Cd1314520/ps5-robotic-arm/hardware/stl/01-base.stl

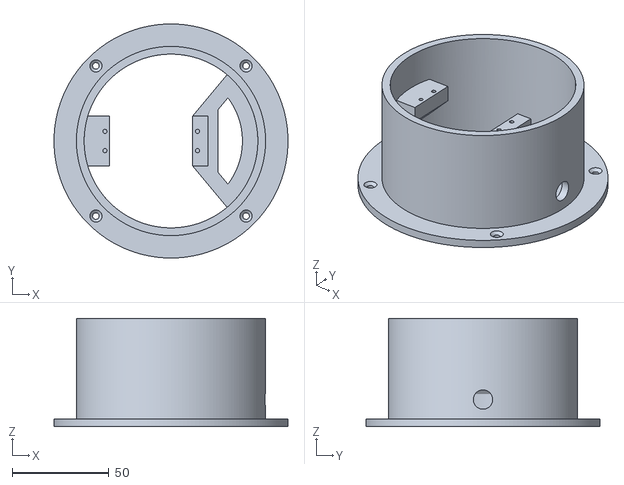
[picture p1: CAD file, 2026-10-28]
hardware/stl/01-base.stl
121.2 x 121.3 x 56.0
