Cd1314520/ps5-robotic-arm/hardware/stl/02-base-mount-mg996r.stl

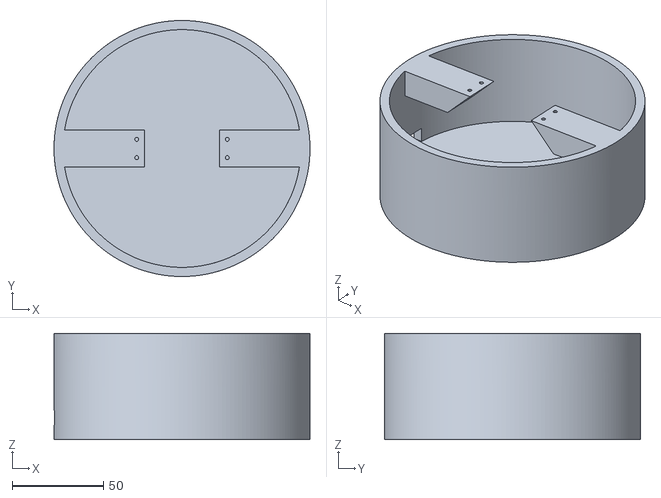
[picture p2: CAD file, 2026-10-28]
hardware/stl/02-base-mount-mg996r.stl
140.0 x 140.0 x 58.0
