Cd1314520/ps5-robotic-arm/hardware/stl/09-gripper-base.stl

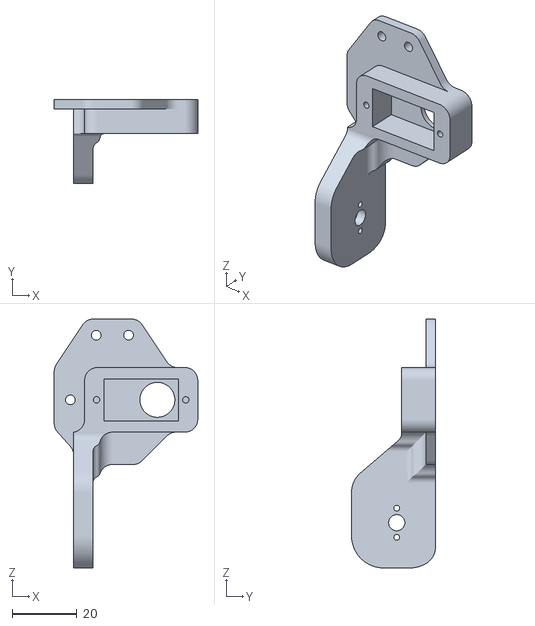
[picture p3: CAD file, 2026-10-28]
hardware/stl/09-gripper-base.stl
44.4 x 26.0 x 77.0
