Cd1314520/ps5-robotic-arm/hardware/stl/05-arm-01.stl

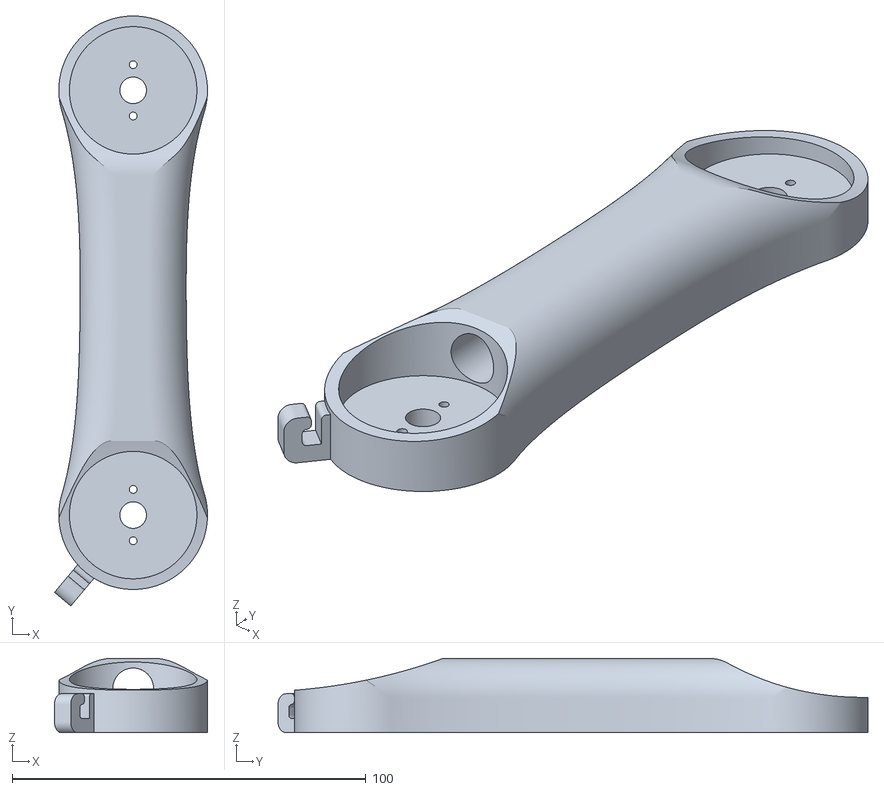
[picture p4: CAD file, 2026-10-28]
hardware/stl/05-arm-01.stl
43.2 x 166.7 x 21.0
