Cd1314520/ps5-robotic-arm/hardware/stl/07-arm-02.stl

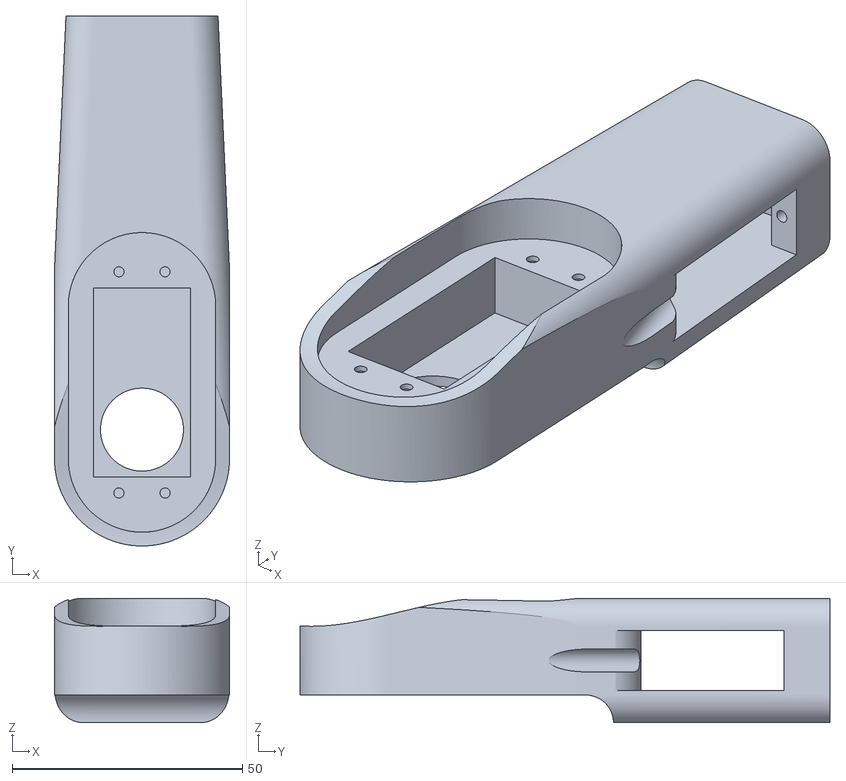
[picture p5: CAD file, 2026-10-28]
hardware/stl/07-arm-02.stl
38.0 x 115.0 x 27.0
