Cd1314520/ps5-robotic-arm/hardware/stl/03-waist.stl

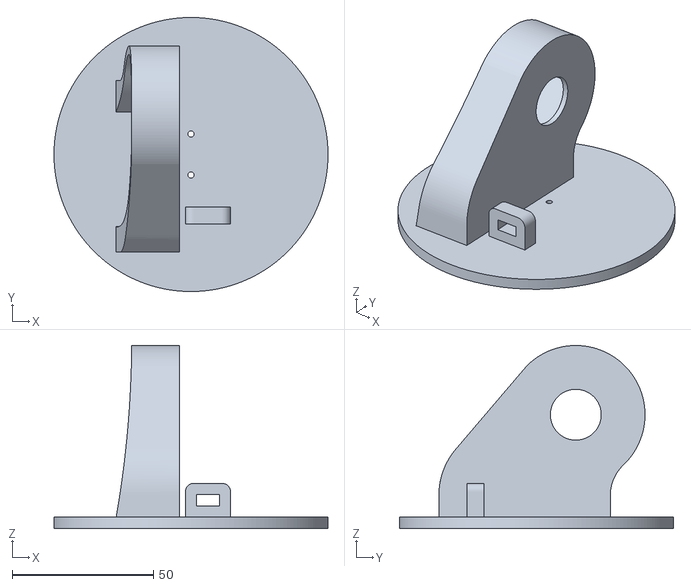
[picture p6: CAD file, 2026-10-28]
hardware/stl/03-waist.stl
97.0 x 97.0 x 64.8
