Cd1314520/ps5-robotic-arm/hardware/stl/08-arm-03.stl

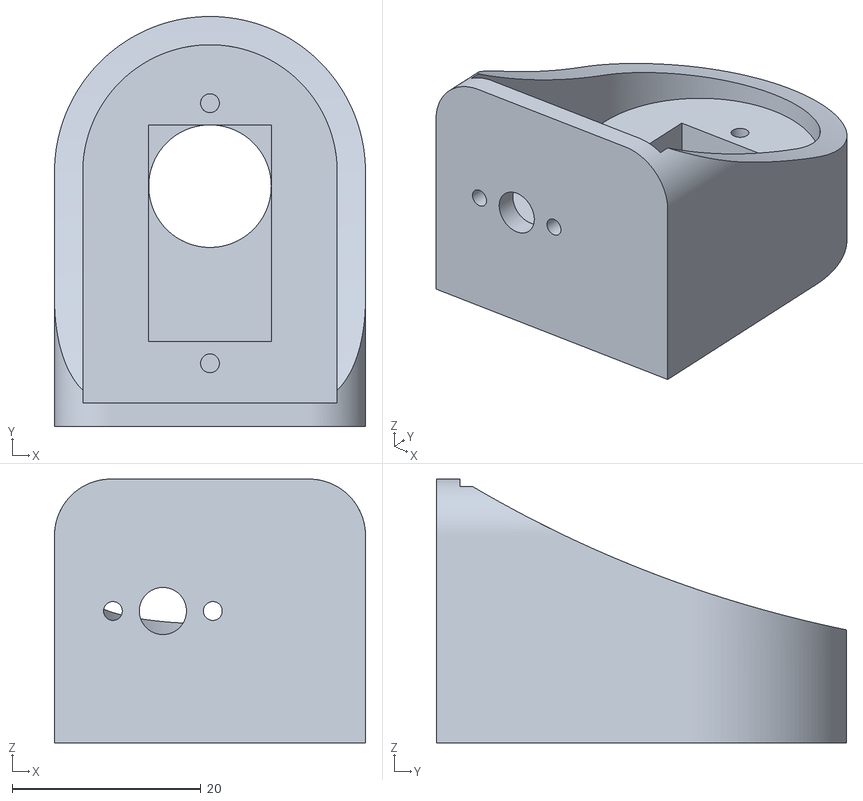
[picture p7: CAD file, 2026-10-28]
hardware/stl/08-arm-03.stl
33.0 x 43.5 x 28.0
