Cd1314520/ps5-robotic-arm/hardware/stl/10-gripper-gear-2.stl

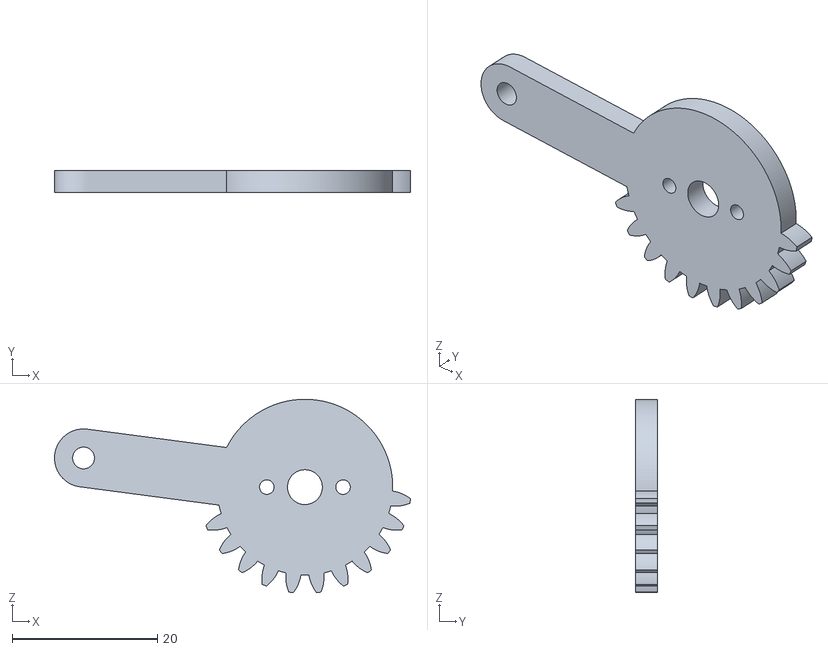
[picture p8: CAD file, 2026-10-28]
hardware/stl/10-gripper-gear-2.stl
49.0 x 3.00 x 26.6
