Cd1314520/ps5-robotic-arm/hardware/stl/06-elbow-mount-mg996r.stl

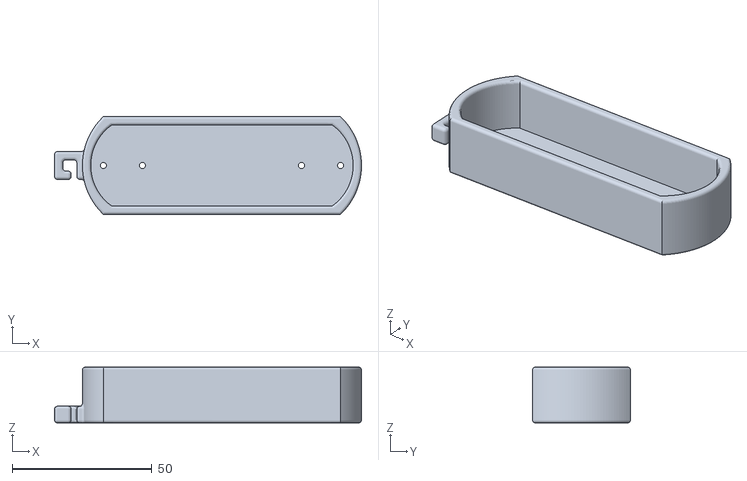
[picture p9: CAD file, 2026-10-28]
hardware/stl/06-elbow-mount-mg996r.stl
110.0 x 35.0 x 20.0
