Cd1314520/ps5-robotic-arm/hardware/stl/04-shoulder-mount-mg996r.stl

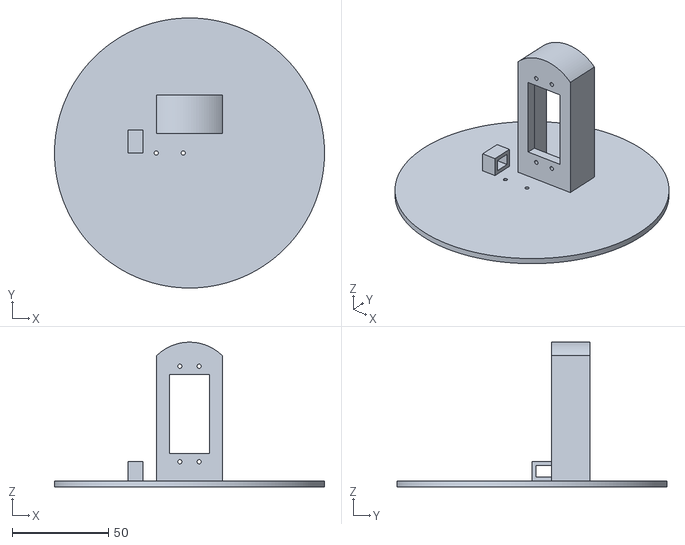
[picture p10: CAD file, 2026-10-28]
hardware/stl/04-shoulder-mount-mg996r.stl
140.0 x 140.0 x 75.0
