Cd1314520/ps5-robotic-arm/(list of files, cad)

Other CAD files:
hardware/source/gripper-assembly.f3d
