Cd1314520/ps5-robotic-arm/(commit log)

2026-08-16 Initial commit: PS5-controlled 6-DOF robotic arm
    Python velocity control (pygame + pyserial) over USB serial to an
    Arduino UNO + PCA9685 driving six servos. Soft limits calibrated on
    hardware and enforced on both the PC and firmware side.
2026-10-28 Turn repo into a beginner step-by-step build tutorial
    - docs/01-09: parts, printing, servo centering, assembly, wiring/power,
    firmware, PC control, calibration, troubleshooting
    - firmware: replace with the firmware actually running on the arm, plus
    one-joint-at-a-time homing on start-up so control.py's start pose matches
    - firmware/servo_center: tool to hold a servo at 90 deg before fitting horns
    - hardware/stl: final printed parts; hardware/source: gripper Fusion 360 file
    - README: overview, tutorial index, credits
    [01-base.stl, 02-base-mount-mg996r.stl, 03-waist.stl, 04-shoulder-mount-mg996r.stl, 05-arm-01.stl, 06-elbow-mount-mg996r.stl, 07-arm-02.stl, 08-arm-03.stl]
